Jezapj/Sonido/ESP32S3WROOMpinout.png

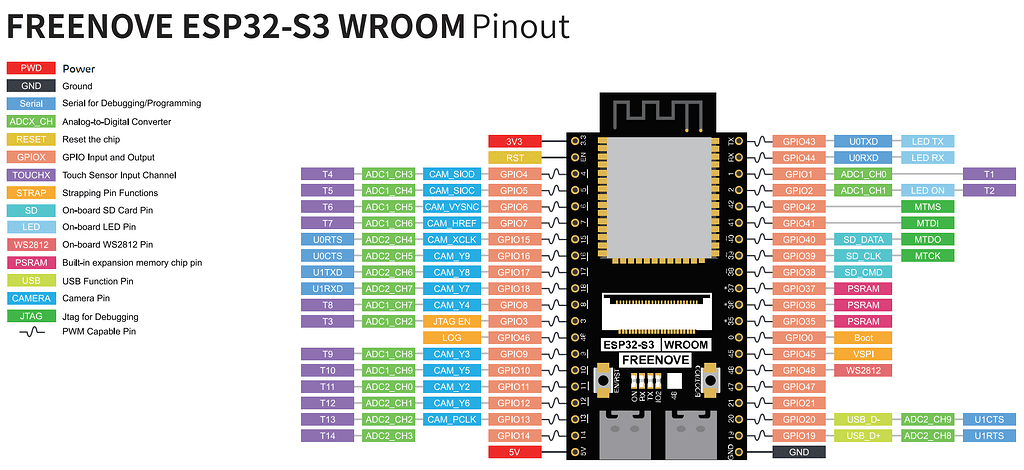
ESP32S3WROOMpinout.png
