Jezapj/Sonido/OVERVIEW.md

# 📖 Sonido / STANZA — Technical Overview

> **Sonido** is a custom guitar effects platform. Analogue guitar audio is captured on an **STM32**, processed as a virtual pedalboard on an **ESP32-S3**, then monitored and controlled from **STANZA** — a Tauri desktop (and Android) app.

The product name in the UI is **STANZA**. This repository holds the board design, MCU firmware, DSP, and host application together.

---

## 🎯 What It Does

```mermaid
flowchart LR
    Guitar[Guitar / Line In] --> AFE[Analogue Front End<br/>(PCB)]
    AFE --> STM32[STM32L432KC<br/>ADC + DMA → SAI I2S Master]
    STM32 --> ESP32[ESP32-S3<br/>I2S RX → Pedal Chain → I2S TX]
    ESP32 --> DAC[I2S DAC<br/>Audio Out]
    ESP32 --> USB[USB Serial<br/>2 Mbaud → Host]
    USB --> STANZA[STANZA App<br/>Tauri / Rust]
    STANZA --> UI[Waveform, Tuner, Looper<br/>Pedal Control, Presets]
```

**STANZA lets you:**
- 🔌 Connect to the board, view live waveform, estimate pitch (FFT + HPS + autocorrelation)
- 🎛️ Enable & tweak named pedals, save knob states as presets
- 🔁 Record, play, overdub, mix loops on host → send to ESP32 for DAC mix-down
- 🎵 Chord bank & metronome on dashboard
- 📱 Compact layout for small screens (~800×480)

---

## 🔊 Signal Path

```
Guitar / Line In
       │
       ▼
Analogue Front End (PCB)
       │
       ▼
STM32L432KC  ADC (DMA) ──► SAI I2S Master TX  (~48 kHz, 16-bit)
       │
       ▼
ESP32-S3  I2S RX ──► Pedal DSP Chain ──► I2S TX to DAC
       │                    │
       │                    └──► USB Serial PCM to Host (2 Mbaud)
       │
       ▼
STANZA (Tauri / Rust)
       │
       ├──► Waveform, Tuner, Looper Capture
       ├──► TYPE A Packets: Pedal Enable + Float Params
       └──► TYPE B Packets: Loop Samples (mixed on ESP32)
```

| Parameter | Value |
|---|---|
| **Sample Rate (ESP32 / Host Looper)** | 47,991 Hz |
| **STM32 SAI Config** | 48 kHz, 16-bit |
| **ESP32 Audio Block Size** | 64 frames |

---

## 🛠️ Hardware

**KiCad Project:** `PCB/StanzaBoard/`

| Component | Role |
|---|---|
| **STM32L432KCU6** | ADC capture, DC offset / scaling, I2S master → ESP32 |
| **ESP32-S3-WROOM-1-N8** | Pedal DSP, USB serial to host, I2S to DAC |
| **Analogue Input** | Guitar line-in conditioning (see `Circuit/` LTspice logs, `PCB/Altium/` footprints) |

> STM32 firmware: `Interface/Mapping/IADCMapping/` (CubeIDE / HAL)  
> Legacy Interface tree also at `Interface/` with same MCU linker script

---

## 📦 Firmware: STM32 (Capture Bridge)

**Path:** `Interface/Mapping/IADCMapping/Core/Src/main.c`

### Key Implementation
- **ADC1** circular DMA → 128-sample buffer
- Each 12-bit sample: centered (DC offset 2048), scaled, written as interleaved 16-bit I2S L/R
- **SAI1 Block A** = I2S Master @ 48 kHz, 16-bit, DMA transmit
- **TIM6** paces ADC
- **GPIO PB3** = boot checkpoint blink

> ⚡ This MCU is an **analogue-to-I2S bridge only** — no pedal models run here.

---

## ⚡ Firmware: ESP32 (DSP Engine)

**Current Sketch:** `Interface/ESP32/I2SESP_V3/`  
**Legacy:** `I2SESP`, `I2SESP_V2` (kept for history)

### V3 Processing Loop

```c
// Simplified main loop
void loop() {
    // 1. Read stereo I2S → fold to mono float
    read_i2s_stereo_to_mono();
    
    // 2. Drain UART for host packets
    drain_uart_packets();
    
    // 3. Run pedal chain (enabled slots in ID order)
    pedal_process_chain();
    
    // 4. Write mono int16 PCM to USB serial (for STANZA)
    write_usb_pcm();
    
    // 5. Mix host loop samples from ring buffer
    mix_loop_audio();
    
    // 6. Write stereo int32 to DAC over I2S
    write_i2s_to_dac();
}
```

### Pedal Registry System
Pedals register via `pedal_registry` (function pointers: `on_params`, `on_process`).  
**Knob field order in each `pedal_*.c` must match `PEDAL_DEFS` in `UI/StanzaUI/src/PedalOverlay.tsx`.**

### Pedal Slots (ID Contract)

| ID | UI Name | Effect |
|----|---|---|
| 0 | **Saturn** | Octave / Pitch Shift |
| 1 | **Blurry Lights** | 3-Band EQ, Pre-Gain, Limiter |
| 2 | **Grain** | Fuzz |
| 3 | **Tabular** | 2nd EQ + Pre-Gain |
| 4 | **Budapest** | Chorus |
| 5 | **Good Boy** | Phaser |
| 6 | **New York** | Overdrive |
| 7 | **Strawberries** | Distortion |
| 8 | **Bridge** | Spring-style Reverb |
| 9 | **Looper** | Host-side (Rust) — *not an ESP32 DSP slot* |

> 📂 `DSP/` contains an earlier C chain (biquad, DC block, EQ params) — reference only, not the live registry.

---

## 🖥️ Host Application: STANZA

**Path:** `UI/StanzaUI/`

### Architecture
| Layer | Technology |
|---|---|
| **Frontend** | React 19, TypeScript, Vite |
| **Backend** | Tauri 2 / Rust (`src-tauri/src/lib.rs`) |
| **Views** | Landing, Home Dashboard, Pedal Board, Profile, Settings |

### Core Modules
- **Serial I/O** — `useSerialStream.ts` (single connection, `audio_chunk` fan-out)
- **Baud Rate:** **2,000,000**
- **DSP Packet Builder** — Rust side
- **Mute & Looper State Machine** — Rust side

### Dashboard Cards
| Card | Features |
|---|---|
| **FFT / Tuner** | Harmonic Product Spectrum + Autocorrelation |
| **Metronome** | Configurable BPM, visual & audio click |
| **Chord Bank** | Song/chord storage |
| **Waveform** | Live serial PCM visualization |
| **Preset Bank** | localStorage, up to 12 named patches, JSON import/export |

### Board View
- Circular gallery of pedals with overlay knobs
- Real-time parameter sync via TYPE A packets

### Settings
- Theme: Light / Dark / System
- Motion reduction
- Background pattern
- Compact layout (`data-compact`)

---

## 🔁 Looper System

| State | Description |
|---|---|
| **Idle** | Ready to record |
| **Recording** | Capturing host audio |
| **Playing** | Loop playback |
| **Overdubbing** | Play + record new layer |
| **Stopped** | Paused, retains buffer |

### Implementation Details
- **Buffer lives on PC** → unlimited by ESP32 RAM
- **ESP32 mixes short ring** for DAC output only
- **Latency compensation:** `OVERDUB_LATENCY_SECS` applied when blending live into overdub
- **Hardware mute** zeros **Blurry Lights** pre-gain (pedal ID 1), not octave slot

---

## 📡 Serial Protocol

### Checksum
XOR of every byte from index 2 through byte before checksum.

### TYPE A — DSP Parameters
**Header:** `0xAA 0x55`

| Byte | Field | Type |
|---|---|---|
| 0 | `0xAA` | Sync |
| 1 | `0x55` | Sync |
| 2 | `pedal_id` | `uint8` |
| 3 | `enabled` | `uint8` (0/1) |
| 4 | `n_params` | `uint8` |
| 5.. | `float32 LE × n_params` | `float32` (little-endian) |
| Last | `XOR` | Checksum |

### TYPE B — Loop Audio
**Header:** `0xAA 0x56`

| Byte | Field | Type |
|---|---|---|
| 0 | `0xAA` | Sync |
| 1 | `0x56` | Sync |
| 2 | `n_samples` | `uint8` / `uint16` |
| 3.. | `int16 LE × n_samples` | `int16` (little-endian) |
| Last | `XOR` | Checksum |

### ESP32 → Host (Continuous Stream)
Raw little-endian `int16` PCM — one sample per processed frame (not packetised).

---

## 🗂️ Repository Map

| Path | Contents |
|---|---|
| `UI/StanzaUI/` | STANZA Tauri app |
| `Interface/ESP32/I2SESP_V3/` | Current ESP32 pedal firmware |
| `Interface/Mapping/IADCMapping/` | STM32 HAL capture firmware |
| `PCB/StanzaBoard/` | KiCad schematic & PCB |
| `PCB/Altium/` | Component library packages |
| `Circuit/` | LTspice / analogue simulation logs |
| `DSP/` | Standalone C DSP experiments |

---

## 💡 Design Notes

> **⚠️ Critical Contract:** Pedal IDs, knob counts, and float order are shared across **three places**:
> 1. ESP32 init (`I2SESP_V3.ino`)
> 2. `UI/StanzaUI/src/PedalOverlay.tsx`
> 3. Rust `update_dsp_params` (Tauri backend)
> 
> Changing one without the others → mis-mapped knobs or wrong slot targeting.

- **Looper buffer on PC** → length not limited by ESP32 RAM
- **Compact UI** (`data-compact`) targets small dedicated screens + normal desktop
- **Hardware mute** targets Blurry Lights (ID 1) pre-gain, not octave slot

---

## 📚 Further Reading

- [README.md](README.md) — Quick start, prerequisites, flashing guide
- [UI/StanzaUI/README.md](UI/StanzaUI/README.md) — UI-specific notes & install history
- [Tauri 2 Docs](https://tauri.app/)
- [STM32CubeIDE](https://www.st.com/en/development-tools/stm32cubeide.html)
- [Arduino ESP32 Core](https://github.com/espressif/arduino-esp32)
