Jezapj/Sonido/PCB/Altium/AltiumLib/ADUM5000ARWZ-RL/RW_16_ADI.step

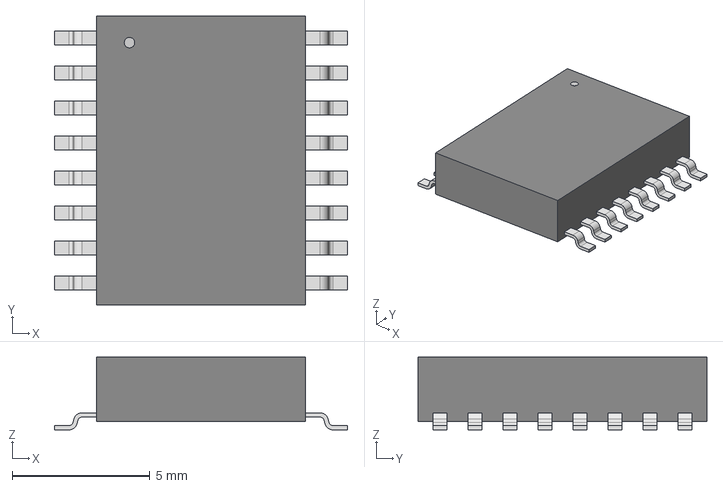
[picture p2: CAD file, 2026-05-26]
PCB/Altium/AltiumLib/ADUM5000ARWZ-RL/RW_16_ADI.step
10.6 x 10.5 x 2.64 mm
