Jezapj/Sonido/PCB/Altium/AltiumLib/LT1677IS8-PBF/SO-8_S_LIT.step

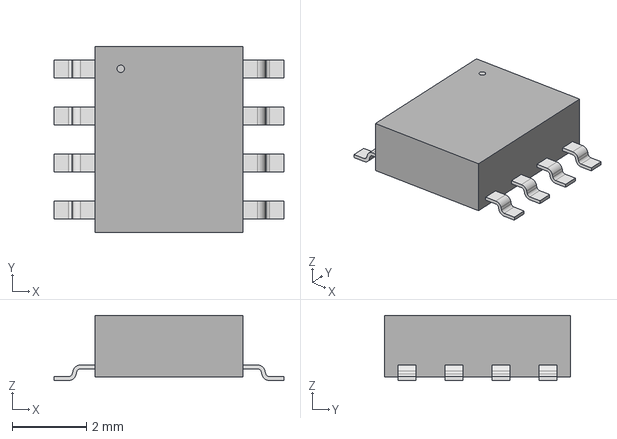
[picture p3: CAD file, 2026-05-26]
PCB/Altium/AltiumLib/LT1677IS8-PBF/SO-8_S_LIT.step
6.20 x 5.00 x 1.75 mm
