Jezapj/Sonido/PCB/sensor module.obj

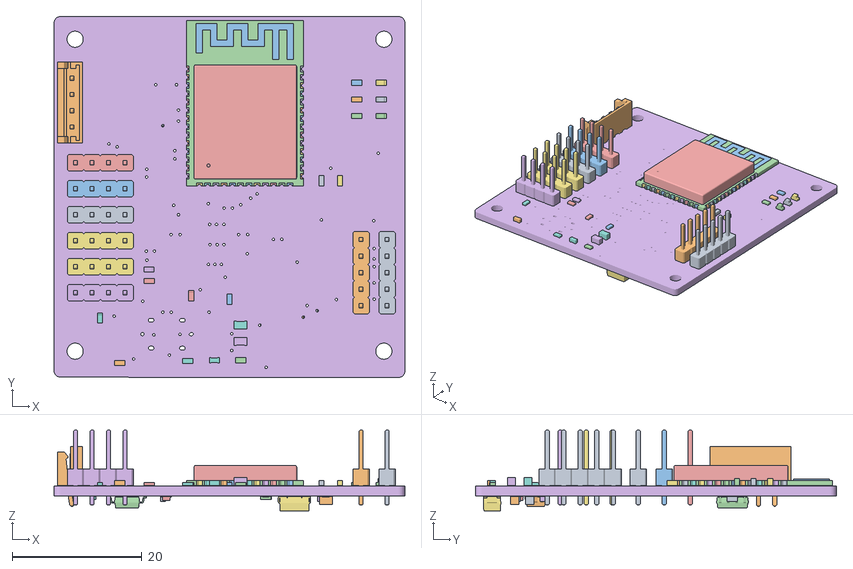
[picture p4: CAD file, 2026-04-26]
PCB/sensor module.obj
54.0 x 55.5 x 12.4
empty_2
empty_3
empty_4
empty_5
empty_6
empty_7
empty_8
empty_9
empty_10
empty_11
empty_12
empty_13
empty_14
empty_15
empty_16
empty_17
empty_18
empty_19
empty_20
empty_21
empty_22
empty_23
empty_24
empty_25
empty_26
empty_27
empty_28
empty_29
empty_30
empty_31
empty_32
empty_33
empty_34
empty_35
empty_36
empty_37
empty_38
empty_39
empty_40
empty_41
empty_42
empty_43
empty_44
empty_45
empty_46
empty_47
empty_48
empty_49
empty_50
empty_51
empty_52
empty_53
empty_54
empty_55
empty_56
empty_57
empty_58
empty_59
empty_60
empty_61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
