Jezapj/Sonido/Circuit/FullPCB.asc

C1: cap; 10µ
C2: cap; 10µ
C3: cap; 100n
C4: cap; 100n
C5: cap; 7nF
R1: res; 10k
R2: res; 10k
R3: res; 220R
R4: res; 2k
R6: res; 1m
TL974: UniversalOpamp2
V1: voltage; SINE(0 0.4 1K); AC 1
V2: voltage; 3.3V
V3: voltage; 5
V4: voltage; 0.33V
V5: voltage; SINE(0 0.2 10k)
Named nets: 0, V-, V+, Vo, Vin
.tran 20m
