Jezapj/Sonido/Circuit/GuitarLineIn.asc

C1: cap; 10µ
C2: cap; 10µ
C3: cap; 100n
C4: cap; 100n
R1: res; 10k
R2: res; 10k
R3: res; 100R
R4: res; 220R
R6: res; 1m
TL974: UniversalOpamp2
V1: voltage; SINE(0 0.8 1K); AC 1
V2: voltage; 5
V3: voltage; 5
V4: voltage; 1V
Named nets: 0, V-, V+, Vo, Vin
.tran 10m
