Jezapj/Sonido/(list of files, drawings)

Other design files:
PCB/Altium/AltiumLib/ADUM5000ARWZ-RL/ADUM5000ARWZ-RL.PcbLib
PCB/Altium/AltiumLib/ADUM5000ARWZ-RL/ADUM5000ARWZ-RL.SchLib
PCB/Altium/AltiumLib/LT1677IS8-PBF/LT1677IS8PBF.PcbLib
PCB/Altium/AltiumLib/LT1677IS8-PBF/LT1677IS8PBF.SchLib
PCB/Altium/AltiumLib/NUCLEO-L432KC/MODULE_NUCLEO-L432KC.PcbLib
PCB/Altium/AltiumLib/NUCLEO-L432KC/NUCLEO-L432KC.SchLib
PCB/Altium/AltiumLib/SSW-110-01-XXX-S/SAMTEC_SSW-110-01-XXX-S.PcbLib
PCB/Altium/AltiumLib/SSW-110-01-XXX-S/SSW-110-01-XXX-S.SchLib
PCB/Altium/AltiumLib/USB4105-GF-A-120/GCT_USB4105-GF-A-120.PcbLib
PCB/Altium/AltiumLib/USB4105-GF-A-120/USB4105-GF-A-120.SchLib
PCB/Altium/AltiumLib/USB4105-GF-A-1201/GCT_USB4105-GF-A-120.PcbLib
PCB/Altium/AltiumLib/USB4105-GF-A-1201/USB4105-GF-A-120.SchLib
PCB/StanzaBoard/Imported StanzaBoard/PCB1.PcbDoc
PCB/StanzaBoard/Imported StanzaBoard/StanzaBoard.PrjPcb
PCB/StanzaBoard/Imported StanzaBoard/StanzaBoard.SchDoc
PCB/StanzaBoard/Imported StanzaBoard/StanzaBoard.SchLib
