Jezapj/Sonido/PCB/StanzaBoardDevkit/StanzaBoardDevkit.kicad_pcb

## KiCad design PCB/StanzaBoardDevkit/StanzaBoardDevkit.kicad_pcb (2026-10-14)

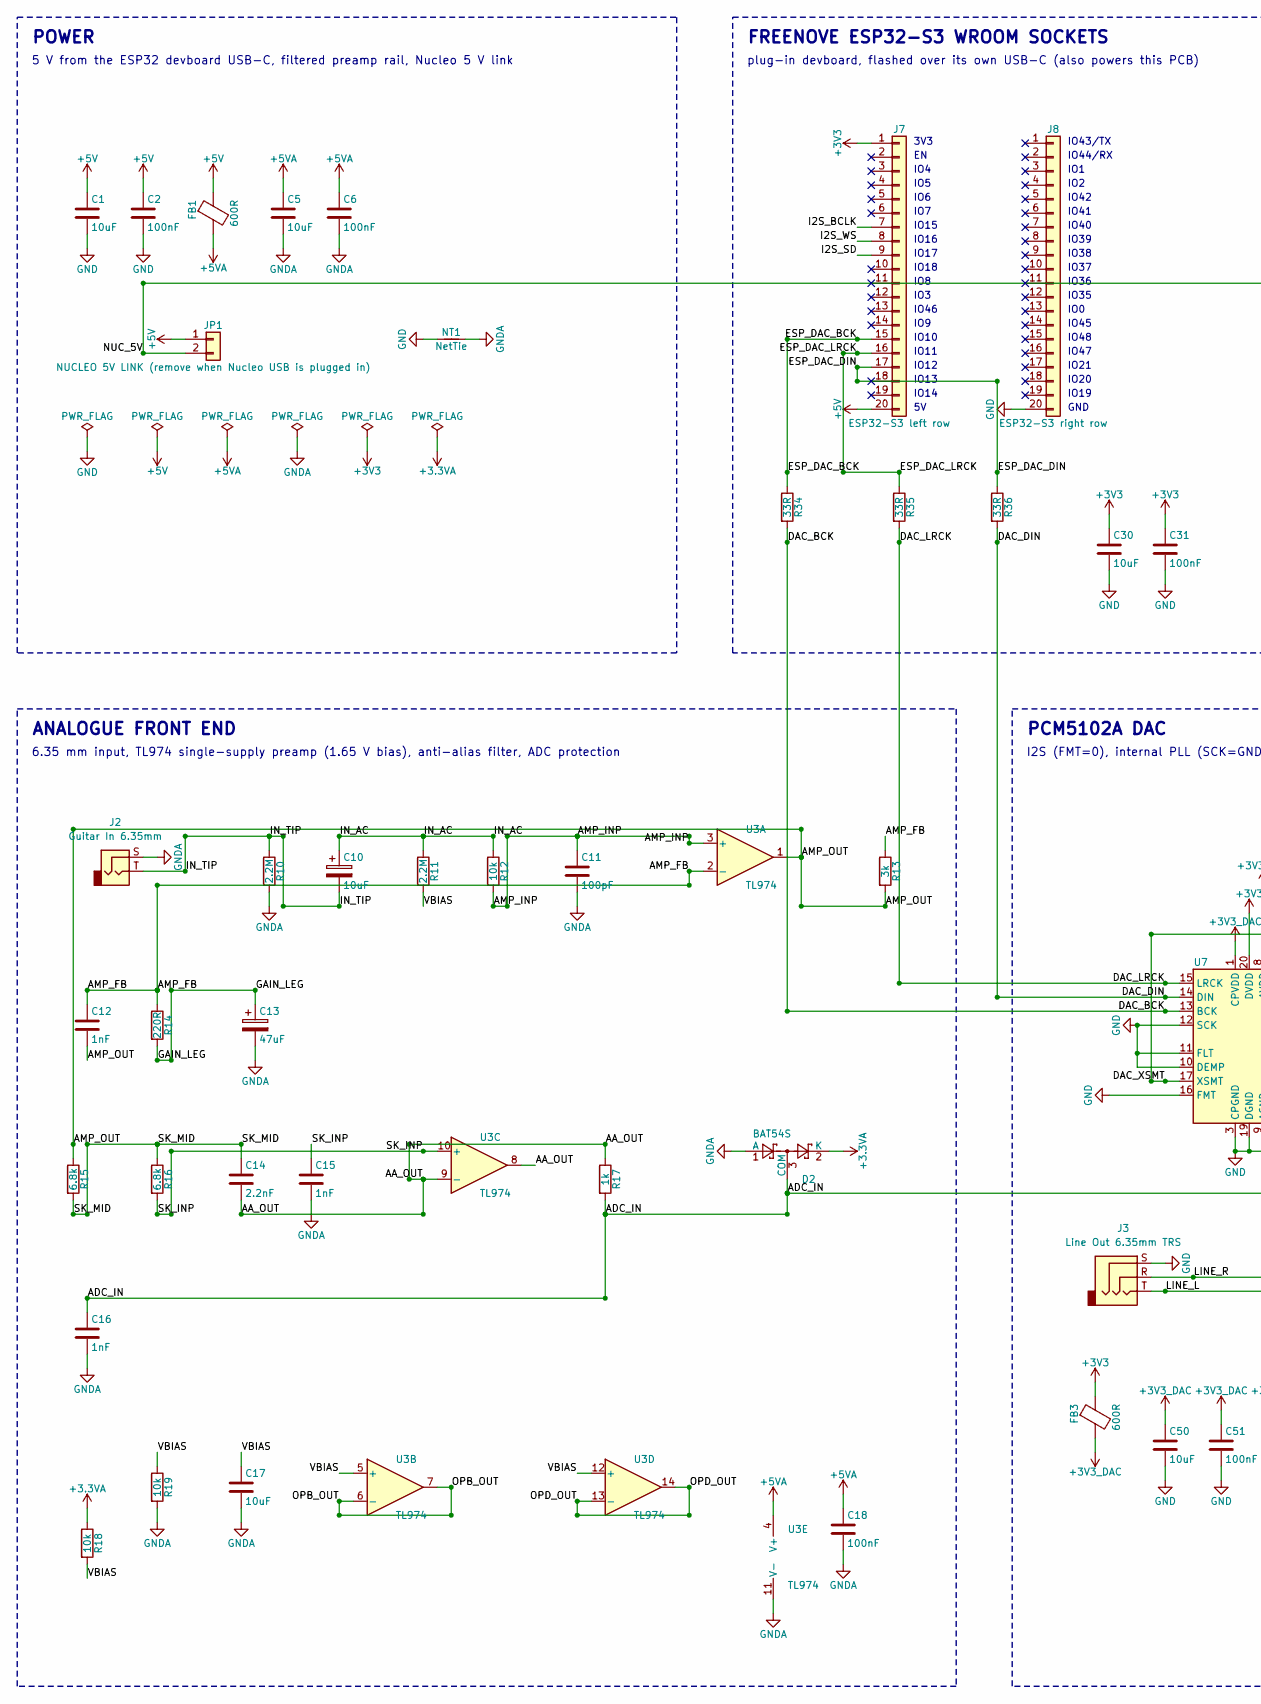
[picture p5: schematic StanzaBoardDevkit.kicad_sch, Stanza Board (devboard version) - Freenove ESP32-S3 + NUCLE…, part in row 1, column 1]

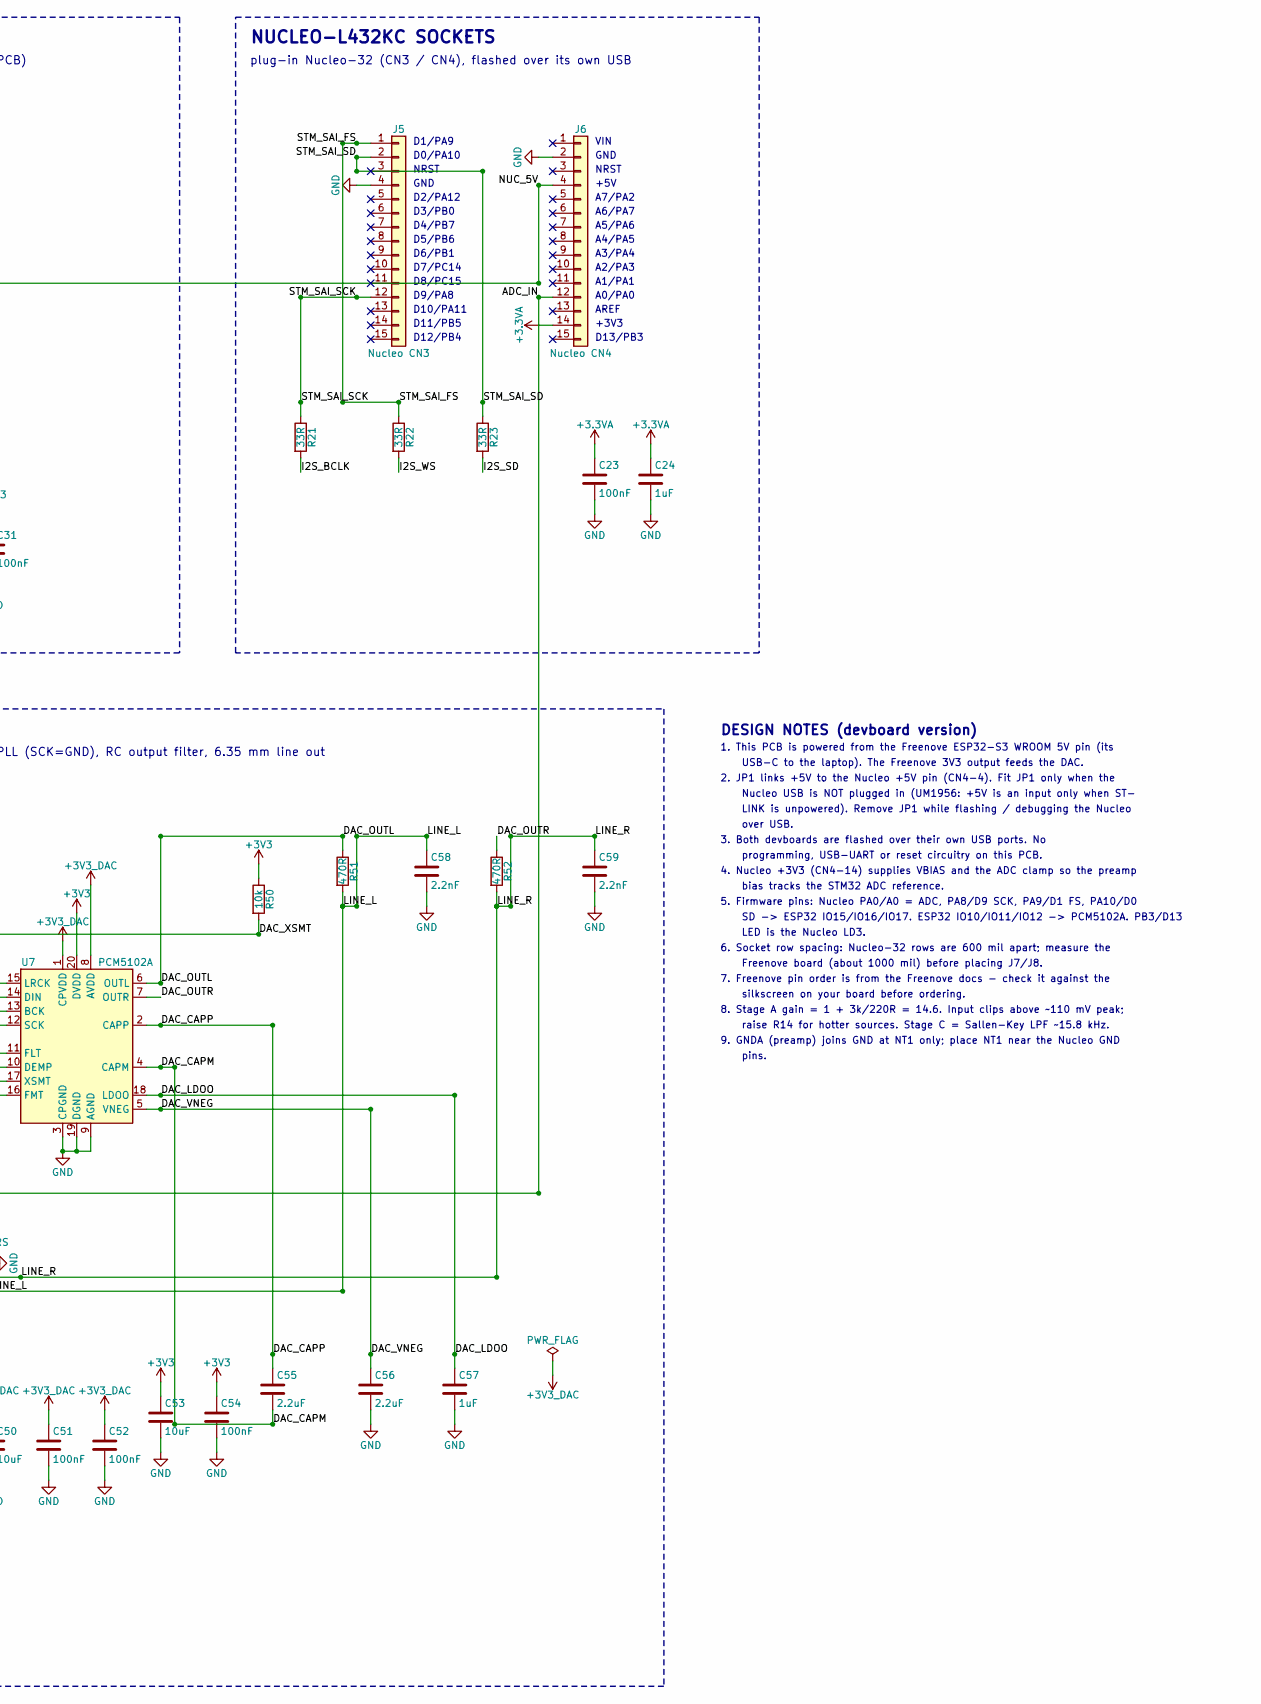
[picture p6: schematic StanzaBoardDevkit.kicad_sch, Stanza Board (devboard version) - Freenove ESP32-S3 + NUCLE…, part in row 1, column 2]

Parts:
C1, C5, C17, C30, C50, C53: 10uF; C_0805_2012Metric
C2, C6, C18, C23, C31, C51, C52, C54: 100nF; C_0603_1608Metric
C10: 10uF; CP_Elec_5x5.4
C11: 100pF; C_0603_1608Metric
C12, C15, C16: 1nF; C_0603_1608Metric
C13: 47uF; CP_Elec_5x5.4
C14, C58, C59: 2.2nF; C_0603_1608Metric
C24, C57: 1uF; C_0603_1608Metric
C55, C56: 2.2uF; C_0603_1608Metric
D2: BAT54S; SOT-23
FB1, FB3: 600R; L_0603_1608Metric
J2: Guitar In 6.35mm; Jack_6.35mm_Neutrik_NMJ4HCD2_Horizontal
J3: Line Out 6.35mm TRS; Jack_6.35mm_Neutrik_NMJ6HCD2_Horizontal
J5: Nucleo CN3; PinSocket_1x15_P2.54mm_Vertical
J6: Nucleo CN4; PinSocket_1x15_P2.54mm_Vertical
J7: ESP32-S3 left row; PinSocket_1x20_P2.54mm_Vertical
J8: ESP32-S3 right row; PinSocket_1x20_P2.54mm_Vertical
JP1: NUCLEO 5V LINK (remove when Nucleo USB is plugged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; PinHeader_1x02_P2.54mm_Vertical
NT1: NetTie; NetTie-2_SMD_Pad0.5mm
R10, R11: 2.2M; R_0603_1608Metric
R12, R18, R19, R50: 10k; R_0603_1608Metric
R13: 3k; R_0603_1608Metric
R14: 220R; R_0603_1608Metric
R15, R16: 6.8k; R_0603_1608Metric
R17: 1k; R_0603_1608Metric
R21, R22, R23, R34, R35, R36: 33R; R_0603_1608Metric
R51, R52: 470R; R_0603_1608Metric
U3: TL974; SOIC-14_3.9x8.7mm_P1.27mm
U7: PCM5102A; TSSOP-20_4.4x6.5mm_P0.65mm

Connections:
+3V3: C30.1, C31.1, C53.1, C54.1, FB3.1, J7.1, R50.1, U7.20 (DVDD)
+3V3_DAC: C50.1, C51.1, C52.1, FB3.2, U7.1 (CPVDD), U7.8 (AVDD)
+5V: C1.1, C2.1, FB1.1, J7.20, JP1.1
+5VA: C5.1, C6.1, C18.1, FB1.2, U3.4 (V+)
/AMP_FB: C12.1, R13.1, R14.1, U3.2 (-)
/AMP_INP: C11.1, R12.2, U3.3 (+)
/AMP_OUT: C12.2, R13.2, R15.1, U3.1
/DAC_BCK: R34.2, U7.13 (BCK)
/DAC_CAPM: C55.2, U7.4 (CAPM)
/DAC_CAPP: C55.1, U7.2 (CAPP)
/DAC_DIN: R36.2, U7.14 (DIN)
/DAC_LDOO: C57.1, U7.18 (LDOO)
/DAC_LRCK: R35.2, U7.15 (LRCK)
/DAC_OUTL: R51.1, U7.6 (OUTL)
/DAC_OUTR: R52.1, U7.7 (OUTR)
/DAC_VNEG: C56.1, U7.5 (VNEG)
/DAC_XSMT: R50.2, U7.17 (XSMT)
/ESP_DAC_BCK: J7.15, R34.1
/ESP_DAC_DIN: J7.17, R36.1
/ESP_DAC_LRCK: J7.16, R35.1
/GAIN_LEG: C13.1, R14.2
/I2S_BCLK: J7.7, R21.2
/I2S_SD: J7.9, R23.2
/I2S_WS: J7.8, R22.2
/IN_AC: C10.1, R11.1, R12.1
/IN_TIP: C10.2, J2.T, R10.1
/LINE_L: C58.1, J3.T, R51.2
/LINE_R: C59.1, J3.R, R52.2
/NUC_5V: J6.4, JP1.2
/OPB_OUT: U3.6 (-), U3.7
/OPD_OUT: U3.13 (-), U3.14
/SK_INP: C15.1, R16.2, U3.10 (+)
/SK_MID: C14.1, R15.2, R16.1
/STM_SAI_FS: J5.1, R22.1
/STM_SAI_SCK: J5.12, R21.1
/STM_SAI_SD: J5.2, R23.1
/VBIAS: C17.1, R11.2, R18.2, R19.1, U3.5 (+), U3.12 (+)
GND: C1.2, C2.2, C23.2, C24.2, C30.2, C31.2, C50.2, C51.2, C52.2, C53.2, C54.2, C56.2, C57.2, C58.2, C59.2, J3.S, J5.4, J6.2, J8.20, NT1.1, U7.3 (CPGND), U7.9 (AGND), U7.10 (DEMP), U7.11 (FLT), U7.12 (SCK), U7.16 (FMT), U7.19 (DGND)

Notes on the sheet:
D1/PA9
D0/PA10
NRST
GND
D2/PA12
D3/PB0
D4/PB7
D5/PB6
D6/PB1
D7/PC14
D8/PC15
D9/PA8
D10/PA11
D11/PB5
D12/PB4
VIN
+5V
A7/PA2
A6/PA7
A5/PA6
A4/PA5
A3/PA4
A2/PA3
A1/PA1
A0/PA0
AREF
+3V3
D13/PB3
3V3
IO4
IO5
IO6
IO7
IO15
IO16
IO17
IO18
IO8
IO3
IO46
IO9
IO10
IO11
IO12
IO13
IO14
IO43/TX
IO44/RX
IO1
IO2
IO42
IO41
IO40
IO39
IO38
IO37
IO36
IO35
IO0
IO45
IO48
IO47
IO21
IO20
IO19
POWER
5 V from the ESP32 devboard USB-C, filtered preamp rail, Nucleo 5 V link
FREENOVE ESP32-S3 WROOM SOCKETS
plug-in devboard, flashed over its own USB-C (also powers this PCB)
NUCLEO-L432KC SOCKETS
plug-in Nucleo-32 (CN3 / CN4), flashed over its own USB
ANALOGUE FRONT END
6.35 mm input, TL974 single-supply preamp (1.65 V bias), anti-alias filter, ADC protection
PCM5102A DAC
I2S (FMT=0), internal PLL (SCK=GND), RC output filter, 6.35 mm line out
DESIGN NOTES (devboard version)
1. This PCB is powered from the Freenove ESP32-S3 WROOM 5V pin (its
USB-C to the laptop). The Freenove 3V3 output feeds the DAC.
2. JP1 links +5V to the Nucleo +5V pin (CN4-4). Fit JP1 only when the
Nucleo USB is NOT plugged in (UM1956: +5V is an input only when ST-
LINK is unpowered). Remove JP1 while flashing / debugging the Nucleo
over USB.
3. Both devboards are flashed over their own USB ports. No
programming, USB-UART or reset circuitry on this PCB.
4. Nucleo +3V3 (CN4-14) supplies VBIAS and the ADC clamp so the preamp
bias tracks the STM32 ADC reference.
5. Firmware pins: Nucleo PA0/A0 = ADC, PA8/D9 SCK, PA9/D1 FS, PA10/D0
SD -> ESP32 IO15/IO16/IO17. ESP32 IO10/IO11/IO12 -> PCM5102A. PB3/D13
LED is the Nucleo LD3.
6. Socket row spacing: Nucleo-32 rows are 600 mil apart; measure the
Freenove board (about 1000 mil) before placing J7/J8.
7. Freenove pin order is from the Freenove docs - check it against the
silkscreen on your board before ordering.
8. Stage A gain = 1 + 3k/220R = 14.6. Input clips above ~110 mV peak;
raise R14 for hotter sources. Stage C = Sallen-Key LPF ~15.8 kHz.
9. GNDA (preamp) joins GND at NT1 only; place NT1 near the Nucleo GND
pins.

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
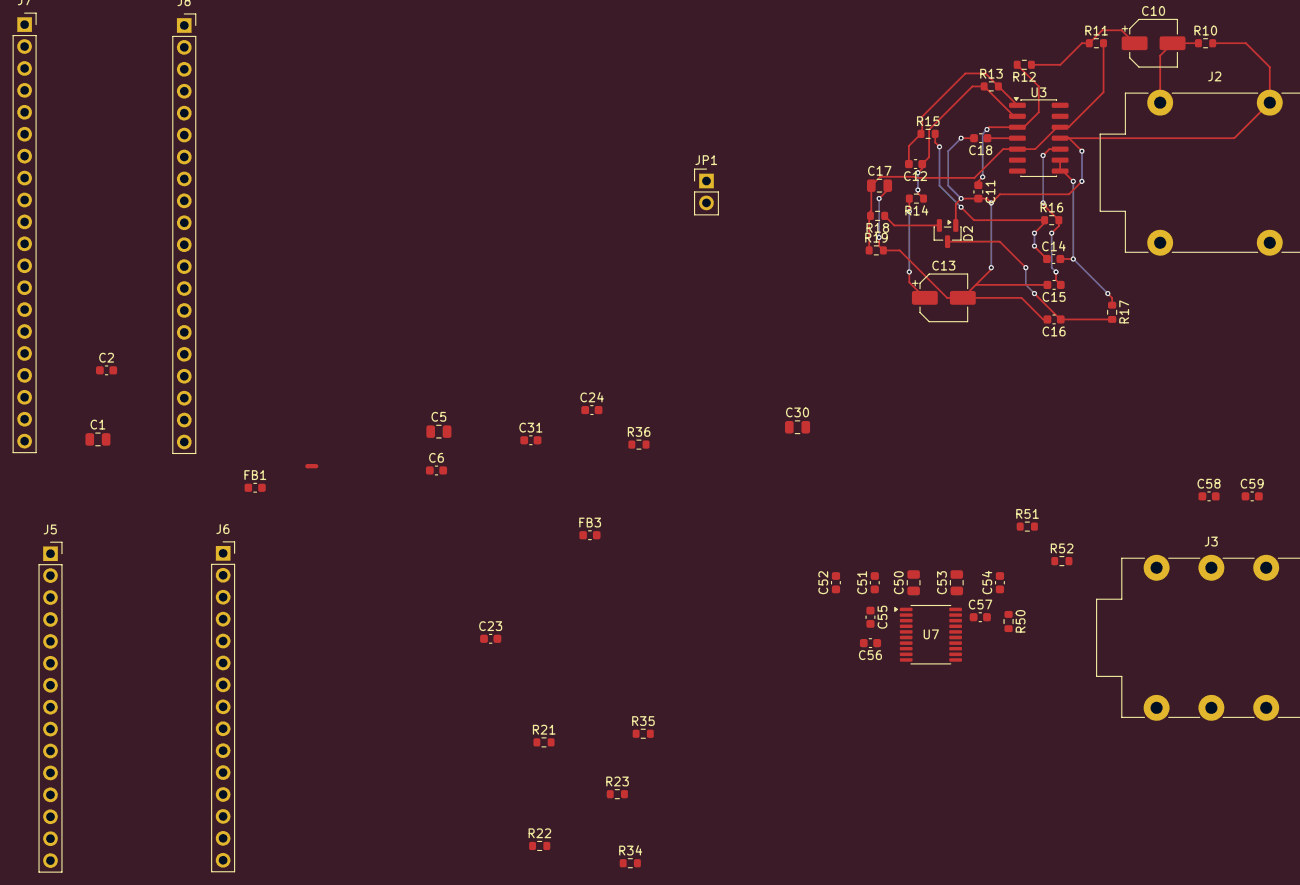
[picture p7: board StanzaBoardDevkit.kicad_pcb from above]

Board: 2 copper layers, 59 parts (0 on the bottom side), 42 nets.
