Jezapj/Sonido/Interface/ESP32/I2SESP_V3/I2SESP_V3.ino

#include <Arduino.h>
#include "driver/i2s_std.h"
#include <string.h>

extern "C" {
    #include "pedal_registry.h"
    #include "pedal_eq.h"
    #include "pedal_chorus.h"
    #include "pedal_od.h"
    #include "pedal_dist.h"
    #include "pedal_phaser.h"
    #include "pedal_reverb.h"
    #include "pedal_octave.h"
    #include "pedal_fuzz.h"
}

// ── Pedal slot IDs ────────────────────────────────────────────────────────────
// Must match PEDAL_IDS in PedalOverlay.tsx and pedal_id values in lib.rs.
#define PEDAL_OCTAVE      0
#define PEDAL_EQ_PREGAIN  1
#define PEDAL_FUZZ        2
#define PEDAL_EQ_PREGAIN2  3
#define PEDAL_CHORUS      4
#define PEDAL_PHASER      5
#define PEDAL_OVERDRIVE   6
#define PEDAL_DISTORTION  7
#define PEDAL_REVERB      8

// ── Audio config ──────────────────────────────────────────────────────────────
#define SAMPLE_RATE 47991
#define BLOCK_SIZE  64

// ── Packet protocol ───────────────────────────────────────────────────────────
//
// TYPE A — DSP params:  [0xAA][0x55][pedal_id][enabled][n_params][float×n][XOR]
// TYPE B — loop audio:  [0xAA][0x56][n_samples][int16×n][XOR]
//
// Checksum: XOR of every byte from index 2 to the byte before the checksum.
//
// The looper buffer lives on the host (Rust / lib.rs). During playback the host
// sends TYPE B packets so the ESP32 can mix loop audio into the DAC output.

#define PKT_MAX_PARAMS   16
#define PKT_HEADER_SIZE  5
#define PKT_BUF_SIZE     80   // 5 header + 16×4 data + 1 checksum = 70; +10 margin
#define LOOP_PKT_MAX     (BLOCK_SIZE + 4)  // header + max samples + checksum

// ── Loop-audio ring buffer (host → DAC mix) ───────────────────────────────────
#define LOOP_RING_SIZE   2048
static int16_t s_loop_ring[LOOP_RING_SIZE];
static int     s_loop_ring_w = 0;
static int     s_loop_ring_r = 0;

static int loop_ring_count(void)
{
    return (s_loop_ring_w - s_loop_ring_r + LOOP_RING_SIZE) % LOOP_RING_SIZE;
}

static void loop_ring_push(int16_t s)
{
    if (loop_ring_count() >= LOOP_RING_SIZE - 1) return;
    s_loop_ring[s_loop_ring_w] = s;
    s_loop_ring_w = (s_loop_ring_w + 1) % LOOP_RING_SIZE;
}

static int16_t loop_ring_pop(void)
{
    if (s_loop_ring_r == s_loop_ring_w) return 0;
    int16_t s = s_loop_ring[s_loop_ring_r];
    s_loop_ring_r = (s_loop_ring_r + 1) % LOOP_RING_SIZE;
    return s;
}

// ── Packet parser state ───────────────────────────────────────────────────────
enum PktKind { PKT_NONE = 0, PKT_PARAM, PKT_LOOP };

static uint8_t  s_pkt[PKT_BUF_SIZE];
static int      s_pkt_idx   = 0;
static uint8_t  s_n_params = 0;
static PktKind  s_pkt_kind  = PKT_NONE;

static uint8_t  s_loop_pkt[LOOP_PKT_MAX];
static int      s_loop_idx  = 0;
static uint8_t  s_loop_n    = 0;

// ── I2S handles ───────────────────────────────────────────────────────────────
static i2s_chan_handle_t tx_handle;
static i2s_chan_handle_t rx_handle;

// ─────────────────────────────────────────────────────────────────────────────
// reset_serial_parsers()
// ─────────────────────────────────────────────────────────────────────────────
static void reset_serial_parsers(void)
{
    s_pkt_idx  = 0;
    s_pkt_kind = PKT_NONE;
    s_loop_idx = 0;
}

// ─────────────────────────────────────────────────────────────────────────────
// drain_serial()
//
// Non-blocking UART drain. Handles TYPE A (DSP params) and TYPE B (loop audio).
// ─────────────────────────────────────────────────────────────────────────────
static void drain_serial(void)
{
    while (Serial.available() > 0)
    {
        uint8_t b = (uint8_t)Serial.read();

        // ── TYPE B loop-audio packet in progress ─────────────────────────────
        if (s_pkt_kind == PKT_LOOP) {
            if (s_loop_idx >= LOOP_PKT_MAX) { reset_serial_parsers(); continue; }
            s_loop_pkt[s_loop_idx++] = b;

            if (s_loop_idx == 3) {
                s_loop_n = s_loop_pkt[2];
                if (s_loop_n == 0 || s_loop_n > BLOCK_SIZE) {
                    reset_serial_parsers();
                    continue;
                }
            }
            if (s_loop_idx < 3) continue;

            int expected = 3 + s_loop_n * 2 + 1;
            if (s_loop_idx < expected) continue;

            uint8_t csum = 0;
            for (int i = 2; i < expected - 1; i++) csum ^= s_loop_pkt[i];
            if (csum == s_loop_pkt[expected - 1]) {
                for (int i = 0; i < s_loop_n; i++) {
                    int16_t s = (int16_t)(s_loop_pkt[3 + i * 2]
                               | (s_loop_pkt[4 + i * 2] << 8));
                    loop_ring_push(s);
                }
            }
            reset_serial_parsers();
            continue;
        }

        // ── TYPE A param packet in progress ──────────────────────────────────
        if (s_pkt_kind == PKT_PARAM) {
            if (s_pkt_idx >= PKT_BUF_SIZE) { reset_serial_parsers(); continue; }
            s_pkt[s_pkt_idx++] = b;

            if (s_pkt_idx == PKT_HEADER_SIZE) {
                s_n_params = s_pkt[4];
                if (s_n_params > PKT_MAX_PARAMS) { reset_serial_parsers(); continue; }
            }
            if (s_pkt_idx < PKT_HEADER_SIZE) continue;

            int expected = PKT_HEADER_SIZE + s_n_params * 4 + 1;
            if (s_pkt_idx < expected) continue;

            uint8_t csum = 0;
            for (int i = 2; i < expected - 1; i++) csum ^= s_pkt[i];
            if (csum == s_pkt[expected - 1]) {
                uint8_t pedal_id = s_pkt[2];
                bool    enabled  = (s_pkt[3] != 0);
                float params[PKT_MAX_PARAMS];
                memcpy(params, s_pkt + PKT_HEADER_SIZE, s_n_params * sizeof(float));
                pedal_dispatch_params(pedal_id, enabled, params, s_n_params);
            }
            reset_serial_parsers();
            continue;
        }

        // ── Idle: sync on magic start byte ───────────────────────────────────
        if (b == 0xAA) {
            s_pkt[0] = b;
            s_pkt_idx = 1;
            continue;
        }

        // ── Second byte selects packet type ──────────────────────────────────
        if (s_pkt_idx == 1) {
            if (b == 0x55) {
                s_pkt[1] = b;
                s_pkt_idx = 2;
                s_pkt_kind = PKT_PARAM;
            } else if (b == 0x56) {
                s_loop_pkt[0] = 0xAA;
                s_loop_pkt[1] = 0x56;
                s_loop_idx = 2;
                s_pkt_kind = PKT_LOOP;
            } else {
                reset_serial_parsers();
            }
        }
    }
}

// ─────────────────────────────────────────────────────────────────────────────
// mix_loop_into_dac()
//
// Pop loop samples queued by TYPE B packets and add them to dsp_out.
// ─────────────────────────────────────────────────────────────────────────────
static void mix_loop_into_dac(float *dsp_out, int frames)
{
    for (int i = 0; i < frames; i++) {
        float s = dsp_out[i] + (float)loop_ring_pop() / 32767.0f;
        if (s >  1.0f) s =  1.0f;
        if (s < -1.0f) s = -1.0f;
        dsp_out[i] = s;
    }
}

// ─────────────────────────────────────────────────────────────────────────────
// setup()
// ─────────────────────────────────────────────────────────────────────────────
void setup()
{
    Serial.begin(2000000); // must match BAUD_RATE in useSerialStream.ts

    // ── RX: I2S0 slave — receives stereo 16-bit from STM32 ───────────────────
    i2s_chan_config_t rx_cfg = I2S_CHANNEL_DEFAULT_CONFIG(I2S_NUM_0, I2S_ROLE_SLAVE);
    rx_cfg.dma_desc_num  = 8;
    rx_cfg.dma_frame_num = 64;
    i2s_new_channel(&rx_cfg, NULL, &rx_handle);

    i2s_std_config_t rx_std_cfg = {
        .clk_cfg  = I2S_STD_CLK_DEFAULT_CONFIG(SAMPLE_RATE),
        .slot_cfg = I2S_STD_PHILIPS_SLOT_DEFAULT_CONFIG(
                        I2S_DATA_BIT_WIDTH_16BIT, I2S_SLOT_MODE_STEREO),
        .gpio_cfg = {
            .mclk = I2S_GPIO_UNUSED, .bclk = GPIO_NUM_15,
            .ws   = GPIO_NUM_16,     .dout = I2S_GPIO_UNUSED,
            .din  = GPIO_NUM_17,
        },
    };
    i2s_channel_init_std_mode(rx_handle, &rx_std_cfg);
    i2s_channel_enable(rx_handle);

    // ── TX: I2S1 master — sends 32-bit audio to PCM5102 DAC ──────────────────
    i2s_chan_config_t tx_cfg = I2S_CHANNEL_DEFAULT_CONFIG(I2S_NUM_1, I2S_ROLE_MASTER);
    tx_cfg.dma_desc_num  = 8;
    tx_cfg.dma_frame_num = 64;
    i2s_new_channel(&tx_cfg, &tx_handle, NULL);

    i2s_std_config_t tx_std_cfg = {
        .clk_cfg  = I2S_STD_CLK_DEFAULT_CONFIG(SAMPLE_RATE),
        .slot_cfg = I2S_STD_PHILIPS_SLOT_DEFAULT_CONFIG(
                        I2S_DATA_BIT_WIDTH_32BIT, I2S_SLOT_MODE_STEREO),
        .gpio_cfg = {
            .mclk = I2S_GPIO_UNUSED, .bclk = GPIO_NUM_10,
            .ws   = GPIO_NUM_11,     .dout = GPIO_NUM_12,
            .din  = I2S_GPIO_UNUSED,
        },
    };
    i2s_channel_init_std_mode(tx_handle, &tx_std_cfg);
    i2s_channel_enable(tx_handle);

    // ── Register pedals ───────────────────────────────────────────────────────
    pedal_octave_init    (PEDAL_OCTAVE,  (float)SAMPLE_RATE);
    pedal_eq_init    (PEDAL_EQ_PREGAIN,  (float)SAMPLE_RATE);
    pedal_fuzz_init    (PEDAL_FUZZ,  (float)SAMPLE_RATE);
    pedal_eq_init    (PEDAL_EQ_PREGAIN2,  (float)SAMPLE_RATE);
    pedal_chorus_init(PEDAL_CHORUS,      (float)SAMPLE_RATE);
    pedal_phaser_init(PEDAL_PHASER,      (float)SAMPLE_RATE);
    pedal_od_init    (PEDAL_OVERDRIVE,   (float)SAMPLE_RATE);
    pedal_dist_init  (PEDAL_DISTORTION,  (float)SAMPLE_RATE);
    pedal_reverb_init(PEDAL_REVERB,      (float)SAMPLE_RATE);

    Serial.println("Pedal chain ready");
}

// ─────────────────────────────────────────────────────────────────────────────
// loop()
// ─────────────────────────────────────────────────────────────────────────────
void loop()
{
    int16_t rx_buf[BLOCK_SIZE * 2];
    int32_t tx_buf[BLOCK_SIZE * 2];
    float   dsp_in  [BLOCK_SIZE];
    float   dsp_out [BLOCK_SIZE];
    float   dsp_temp[BLOCK_SIZE];

    size_t bytes_read    = 0;
    size_t bytes_written = 0;

    // Blocking I2S read — lowest jitter
    i2s_channel_read(rx_handle, rx_buf, sizeof(rx_buf),
                     &bytes_read, portMAX_DELAY);

    // Drain any pending host packets (DSP params + loop audio).
    drain_serial();

    int frames = bytes_read >> 2; // 4 bytes per stereo int16 frame

    // ── Stereo int16 → mono float ─────────────────────────────────────────────
    for (int i = 0; i < frames; i++) {
        int32_t s = ((int32_t)rx_buf[i*2] + (int32_t)rx_buf[i*2+1]) << 15;
        dsp_in[i] = s / 2147483648.0f;
    }

    // ── Pedal DSP chain ───────────────────────────────────────────────────────
    pedal_process_chain(dsp_in, dsp_out, dsp_temp, frames);

    // ── Serial stream → host (mono int16 PCM for waveform / looper capture) ───
    int16_t serial_buf[BLOCK_SIZE];
    for (int i = 0; i < frames; i++) {
        float s = dsp_out[i];
        if (s >  1.0f) s =  1.0f;
        if (s < -1.0f) s = -1.0f;
        serial_buf[i] = (int16_t)(s * 32767.0f);
    }
    Serial.write((uint8_t *)serial_buf, frames * sizeof(int16_t));

    // Brief window for the host to return TYPE B loop-audio for this block.
    unsigned long deadline = micros() + 800;
    while (micros() < deadline && Serial.available() > 0) {
        drain_serial();
    }

    // Mix host loop playback into the live DSP signal before the DAC.
    mix_loop_into_dac(dsp_out, frames);

    // ── Mono float → stereo int32 → DAC ──────────────────────────────────────
    for (int i = 0; i < frames; i++) {
        float s = dsp_out[i];
        if (s >  1.0f) s =  1.0f;
        if (s < -1.0f) s = -1.0f;
        int32_t samp    = (int32_t)(s * 2147483647.0f);
        tx_buf[i*2]     = samp;
        tx_buf[i*2 + 1] = samp;
    }
    i2s_channel_write(tx_handle, tx_buf,
                      frames * 2 * sizeof(int32_t),
                      &bytes_written, portMAX_DELAY);
}
