Jezapj/Sonido/Interface/Mapping/IADCMapping/Core/Src/main.c

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
/* Includes ------------------------------------------------------------------*/
#include "main.h"

ADC_HandleTypeDef hadc1;
DMA_HandleTypeDef hdma_adc1;

SAI_HandleTypeDef hsai_BlockA1;
DMA_HandleTypeDef hdma_sai1_a;

TIM_HandleTypeDef htim6;

/* USER CODE BEGIN PV */
#define ADC_BUF_SIZE 128

// SAI I2S standard always clocks 2 slots (L+R) per frame even in mono mode.
// The DMA transfer unit is one 16-bit half-word per slot, so for 128 audio
// samples we need 128*2 = 256 half-words in the I2S buffer.
// We interleave: even indices = Left (audio), odd indices = Right (silence).
#define AUDIO_SAMPLES  ADC_BUF_SIZE
#define I2S_BUF_SIZE   (AUDIO_SAMPLES * 2)   // 256 half-words

uint16_t adc_buf[ADC_BUF_SIZE];
int16_t  i2s_buf[I2S_BUF_SIZE];              // interleaved L, R, L, R, ...

/* USER CODE END PV */

void SystemClock_Config(void);
static void MX_GPIO_Init(void);
static void MX_DMA_Init(void);
static void MX_ADC1_Init(void);
static void MX_TIM6_Init(void);
static void MX_SAI1_Init(void);
/* USER CODE BEGIN 0 */
void forcesilence(void) {
    memset(i2s_buf, 0, sizeof(i2s_buf));
}

// Helper: convert one ADC sample and write both L and R slots in i2s_buf.
// 'adc_idx'  - index into adc_buf  (0 .. ADC_BUF_SIZE-1)
// 'i2s_base' - first slot index for this sample (always 2*adc_idx)
static inline void convert_sample(int adc_idx, int i2s_base)
{
#define DC_OFFSET  2048
#define NOISE_GATE 0

    int32_t s = ((int32_t)adc_buf[adc_idx] - DC_OFFSET) * 16;
    if (s >  32767) s =  32767;
    if (s < -32768) s = -32768;
    int16_t sample = (int16_t)s;
    int32_t abs_s  = sample < 0 ? -sample : sample;
    int16_t out    = abs_s < NOISE_GATE ? 0 : sample;

    i2s_buf[i2s_base]     = out;   // Left  slot  — carries audio
    i2s_buf[i2s_base + 1] = out;     // Right slot  — also carrying audio
}
/* USER CODE END 0 */

/**
  * @brief  The application entry point.
  * @retval int
  */
int main(void)
{

  /* MCU Configuration--------------------------------------------------------*/

  /* Reset of all peripherals, Initializes the Flash interface and the Systick. */
  HAL_Init();

  /* Configure the system clock */
  SystemClock_Config();

  /* Initialize all configured peripherals */
  MX_GPIO_Init();
  MX_DMA_Init();
  MX_ADC1_Init();
  MX_TIM6_Init();
  MX_SAI1_Init();
  /* USER CODE BEGIN 2 */

  /* USER CODE BEGIN 2 */

  // Checkpoint 1
  HAL_GPIO_TogglePin(GPIOB, GPIO_PIN_3);
  HAL_Delay(500);

  // Calibrate ADC
  HAL_ADCEx_Calibration_Start(&hadc1, ADC_SINGLE_ENDED);
  HAL_Delay(10);

  // Pre-fill i2s_buf with silence so SAI DMA has valid data immediately
  //forcesilence();

  // Start ADC DMA
  HAL_ADC_Start_DMA(&hadc1, (uint32_t*)adc_buf, ADC_BUF_SIZE);

  // Start SAI DMA — pass I2S_BUF_SIZE (256 half-words = 128 stereo frames)
  HAL_SAI_Transmit_DMA(&hsai_BlockA1, (uint8_t*)i2s_buf, I2S_BUF_SIZE);

  // Start timer last
  HAL_TIM_Base_Start(&htim6);

  // Checkpoint 5 - everything passed
  HAL_GPIO_TogglePin(GPIOB, GPIO_PIN_3);
  HAL_Delay(500);
  HAL_GPIO_TogglePin(GPIOB, GPIO_PIN_3);
  HAL_Delay(500);
  HAL_GPIO_TogglePin(GPIOB, GPIO_PIN_3);
  HAL_Delay(500);
  HAL_GPIO_TogglePin(GPIOB, GPIO_PIN_3);
  HAL_Delay(5000);
  HAL_GPIO_TogglePin(GPIOB, GPIO_PIN_3);
  HAL_Delay(500);

  /* USER CODE END 2 */

  /* Infinite loop */
  /* USER CODE BEGIN WHILE */
  while (1)
  {
    /* USER CODE END WHILE */

    /* USER CODE BEGIN 3 */
  }
  /* USER CODE END 3 */
}

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
/* USER CODE BEGIN 4 */

/* Process first half of buffers (0 to 63) */
void HAL_ADC_ConvHalfCpltCallback(ADC_HandleTypeDef* hadc) {
    // 1. Process the audio samples
    for (int i = 0; i < 64; i++) {
        convert_sample(i, i * 2);
    }

    // 2. Closed-Loop Clock Synchronization (SPLL)
    // Get remaining half-words to transfer in the circular SAI DMA buffer
    uint32_t remaining = __HAL_DMA_GET_COUNTER(&hdma_sai1_a);
    // Convert to a sample index (0 to 127)
    uint32_t sai_sample_idx = (I2S_BUF_SIZE - remaining) / 2;

    // When ADC finishes the first half (0-63), the SAI reader should ideally 
    // be dead-center in the second half (index 96) to maximize safety margin.
    int32_t error = (int32_t)sai_sample_idx - 96;

    // Handle circular wrap-around corrections
    if (error > 64)  error -= 128;
    if (error < -64) error += 128;

    // Micro-adjust TIM6 auto-reload register based on drift direction
    if (error > 0) {
        TIM6->ARR = 1665; // SAI is running ahead; speed up the ADC
    } else if (error < 0) {
        TIM6->ARR = 1667; // SAI is lagging behind; slow down the ADC
    } else {
        TIM6->ARR = 1666; // Perfectly matched phase
    }
}

/* Process second half of buffers (64 to 127) */
void HAL_ADC_ConvCpltCallback(ADC_HandleTypeDef* hadc) {
    // 1. Process the audio samples
    for (int i = 64; i < 128; i++) {
        convert_sample(i, i * 2);
    }

    // 2. Closed-Loop Clock Synchronization (SPLL)
    uint32_t remaining = __HAL_DMA_GET_COUNTER(&hdma_sai1_a);
    uint32_t sai_sample_idx = (I2S_BUF_SIZE - remaining) / 2;

    // When ADC finishes the second half (64-127), the SAI reader should ideally 
    // be dead-center in the first half (index 32).
    int32_t error = (int32_t)sai_sample_idx - 32;

    if (error > 64)  error -= 128;
    if (error < -64) error += 128;

    if (error > 0) {
        TIM6->ARR = 1665; // SAI is running ahead; speed up the ADC
    } else if (error < 0) {
        TIM6->ARR = 1667; // SAI is lagging behind; slow down the ADC
    } else {
        TIM6->ARR = 1666; // Perfectly matched phase
    }
}

/* USER CODE END 4 */
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
