Jezapj/Sonido/(commit log)

2026-02-21 Added Input to STM32 Stage functionality
2026-02-21 Added Guitar Circuit SPICE file
2026-02-21 Added STM32 to ESP32-S3 Stage
2026-04-06 Started PCB design
    [StanzaBoard.kicad_pcb, StanzaBoard.kicad_sch]
2026-04-07 Audio fixed to sound better, major clock desync fixed
    [GuitarLineInSetupRefV2.ini, IADCMapping.ioc, main.c]
2026-04-19 Added basic landing page with background and icons
2026-04-26 Fixed Dashboard Spacing
    [sensor module.obj]
2026-05-11 Added typing text on landing and lightmode pedal images to use
2026-05-11 Added Dock changes coupling previous commit
2026-05-26 Fixed the STM32 to ESP32 I2S drift issue via periodic circular wrap around corrections
    [main.c]
2026-05-26 Added backing track functionality
2026-05-26 Added interim looping fix and moved web port to 3000 from 1420
    [I2SESP_V3.ino]
2026-05-26 Adding setup adjustments (PreAmp and STM32)
    [ADUM5000ARWZ-RL.PcbLib, ADUM5000ARWZ-RL.SchLib, GCT_USB4105-GF-A-120.PcbLib, LT1677IS8PBF.PcbLib, LT1677IS8PBF.SchLib, MODULE_NUCLEO-L432KC.PcbLib, NUCLEO-L432KC.SchLib, RW_16_ADI.step]
2026-10-14 Progressing PCB devboard version
2026-10-17 Enhance DashboardChordBank with folder management features and improve drag-and-drop functionality. Updated DashboardAudio to prevent drag conflicts with song list. Adjusted button styles for consist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
